ioanlarionov/pinbot-hardware/docs/review/structure.drawio.png

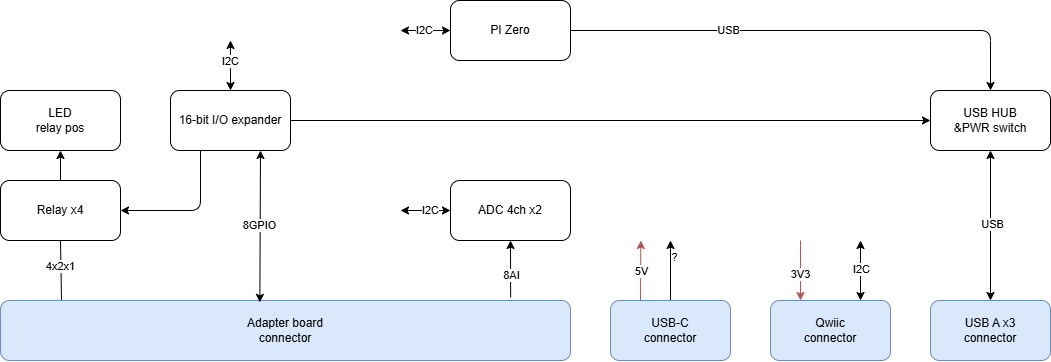
docs/review/structure.drawio.png
